ushicow/A2PDP11/kicad/a2pdp11.kicad_pcb

## KiCad design kicad/a2pdp11.kicad_pcb (2024-11-17)

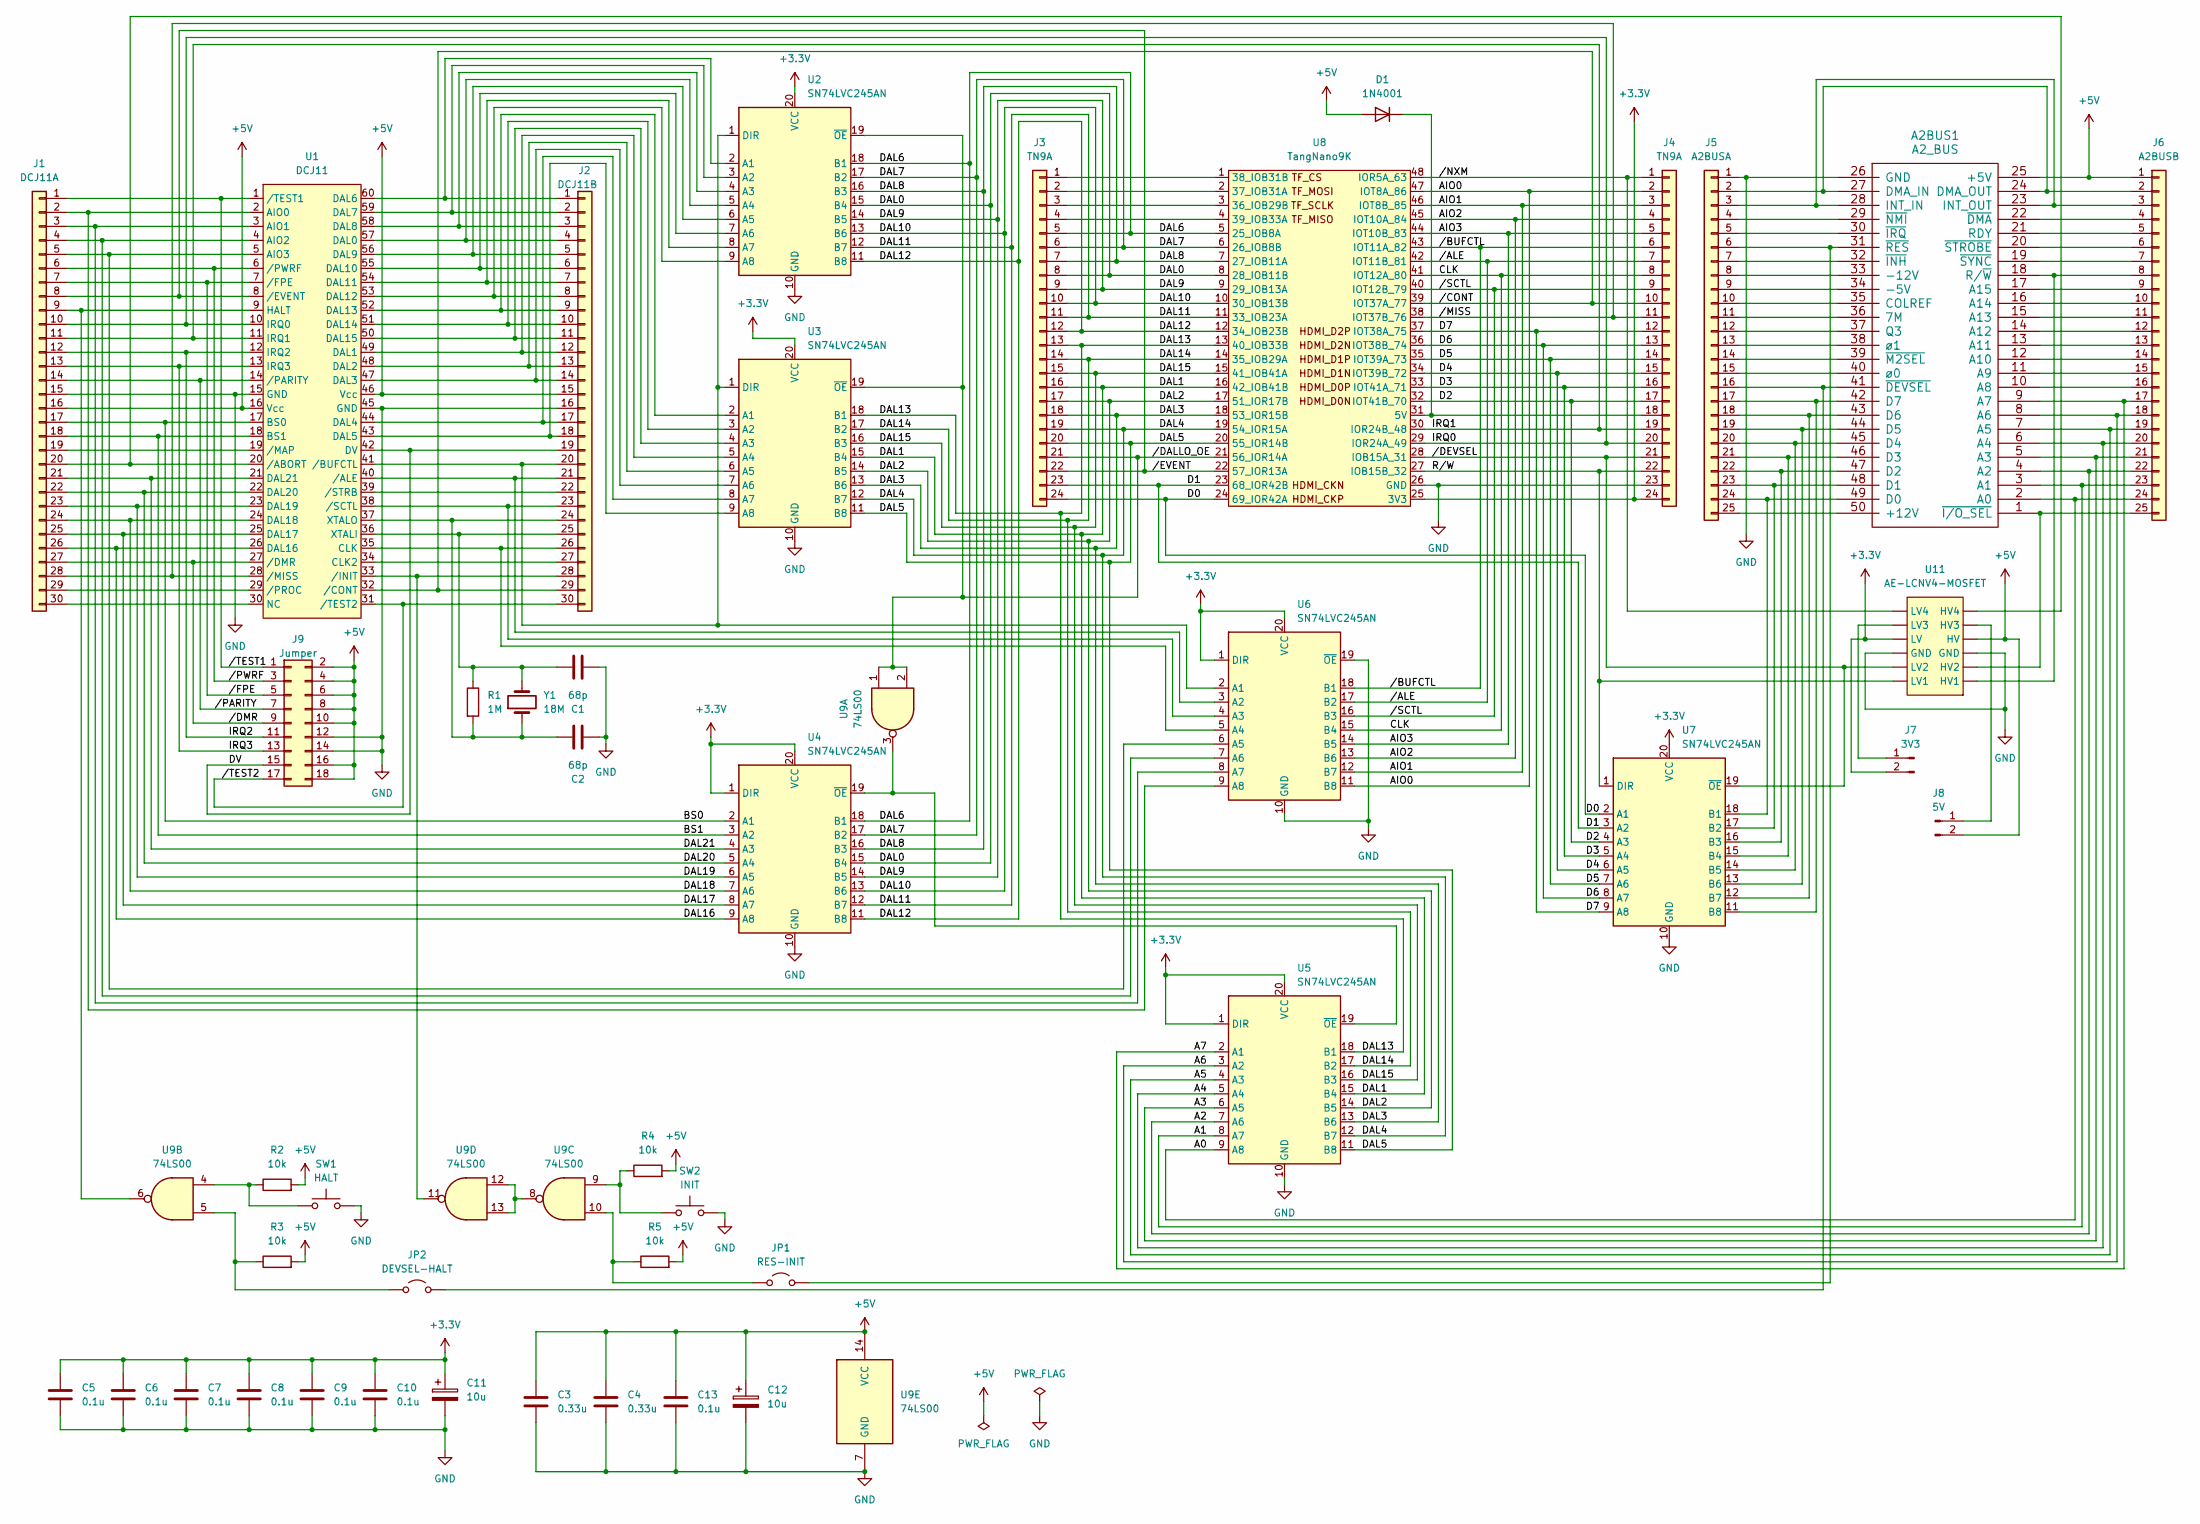
[picture p1: schematic a2pdp11.kicad_sch, J11 Test 17]

Parts:
A2BUS1: A2_BUS; BUS_A2
C1, C2: 68p; C_Disc_D3.0mm_W1.6mm_P2.54mm
C3, C4: 0.33u; C_Disc_D4.3mm_W1.9mm_P5.08mm
C5, C6, C7, C8, C9, C10, C13: 0.1u; C_Disc_D4.3mm_W1.9mm_P5.08mm
C11, C12: 10u; CP_Radial_D5.0mm_P2.00mm
D1: 1N4001; D_DO-41_SOD81_P10.16mm_Horizontal
J1: DCJ11A; PinHeader_1x30_P2.54mm_Vertical
J2: DCJ11B; PinHeader_1x30_P2.54mm_Vertical
J3, J4: TN9A; PinHeader_1x24_P2.54mm_Vertical
J5: A2BUSA; PinHeader_1x25_P2.54mm_Vertical
J6: A2BUSB; PinHeader_1x25_P2.54mm_Vertical
J7: 3V3; PinHeader_1x02_P2.54mm_Vertical
J8: 5V; PinHeader_1x02_P2.54mm_Vertical
J9: Jumper; PinHeader_2x09_P2.54mm_Vertical
JP1: RES-INIT; PinHeader_2x01_P2.54mm_Vertical
JP2: DEVSEL-HALT; PinHeader_2x01_P2.54mm_Vertical
R1: 1M; R_Axial_DIN0207_L6.3mm_D2.5mm_P10.16mm_Horizontal
R2, R3, R4, R5: 10k; R_Axial_DIN0207_L6.3mm_D2.5mm_P10.16mm_Horizontal
SW1: HALT; SW_PUSH_6mm_H4.3mm
SW2: INIT; SW_PUSH_6mm_H4.3mm
U1: DCJ11
U2, U3, U4, U5, U6, U7: SN74LVC245AN; DIP-20_W7.62mm
U8: TangNano9K
U9: 74LS00; DIP-14_W7.62mm_Socket
U11: AE-LCNV4-MOSFET
Y1: 18M; Crystal_HC18-U_Horizontal

Connections:
+3.3V: C5.1, C6.1, C7.1, C8.1, C9.1, C10.1, C11.1, J4.24, J7.2, U2.20 (VCC), U3.20 (VCC), U4.1 (DIR), U4.20 (VCC), U5.1 (DIR), U5.20 (VCC), U6.1 (DIR), U6.20 (VCC), U7.20 (VCC), U8.25 (3V3), U11.9 (LV)
+5V: A2BUS1.25 (+5V), C3.1, C4.1, C12.1, C13.1, D1.2 (A), J1.16, J2.15, J6.1, J8.2, J9.2, J9.4, J9.6, J9.8, J9.10, J9.16, J9.18, R2.2, R3.2, R4.2, R5.2, U1.16 (Vcc), U1.46 (Vcc), U9.14 (VCC), U11.4 (HV)
/A0: A2BUS1.2 (A0), J6.24, U5.9 (A8)
/A1: A2BUS1.3 (A1), J6.23, U5.8 (A7)
/A2: A2BUS1.4 (A2), J6.22, U5.7 (A6)
/A3: A2BUS1.5 (A3), J6.21, U5.6 (A5)
/A4: A2BUS1.6 (A4), J6.20, U5.5 (A4)
/A5: A2BUS1.7 (A5), J6.19, U5.4 (A3)
/A6: A2BUS1.8 (A6), J6.18, U5.3 (A2)
/A7: A2BUS1.9 (A7), J6.17, U5.2 (A1)
/AIO0: J4.2, U6.11 (B8), U8.47 (IOT8A_86)
/AIO1: J4.3, U6.12 (B7), U8.46 (IOT8B_85)
/AIO2: J4.4, U6.13 (B6), U8.45 (IOT10A_84)
/AIO3: J4.5, U6.14 (B5), U8.44 (IOT10B_83)
/BS0: J1.17, U1.17 (BS0), U4.2 (A1)
/BS1: J1.18, U1.18 (BS1), U4.3 (A2)
/CLK: J4.8, U6.15 (B4), U8.41 (IOT12A_80)
/D0: J3.24, U7.2 (A1), U8.24 (69_IOR42A)
/D1: J3.23, U7.3 (A2), U8.23 (68_IOR42B)
/D2: J4.17, U7.4 (A3), U8.32 (IOT41B_70)
/D3: J4.16, U7.5 (A4), U8.33 (IOT41A_71)
/D4: J4.15, U7.6 (A5), U8.34 (IOT39B_72)
/D5: J4.14, U7.7 (A6), U8.35 (IOT39A_73)
/D6: J4.13, U7.8 (A7), U8.36 (IOT38B_74)
/D7: J4.12, U7.9 (A8), U8.37 (IOT38A_75)
/DAL0: J3.8, U2.15 (B4), U4.15 (B4), U8.8 (28_IOB11B)
/DAL1: J3.16, U3.15 (B4), U5.15 (B4), U8.16 (42_IOB41B)
/DAL2: J3.17, U3.14 (B5), U5.14 (B5), U8.17 (51_IOR17B)
/DAL3: J3.18, U3.13 (B6), U5.13 (B6), U8.18 (53_IOR15B)
/DAL4: J3.19, U3.12 (B7), U5.12 (B7), U8.19 (54_IOR15A)
/DAL5: J3.20, U3.11 (B8), U5.11 (B8), U8.20 (55_IOR14B)
/DAL6: J3.5, U2.18 (B1), U4.18 (B1), U8.5 (25_IOB8A)
/DAL7: J3.6, U2.17 (B2), U4.17 (B2), U8.6 (26_IOB8B)
/DAL8: J3.7, U2.16 (B3), U4.16 (B3), U8.7 (27_IOB11A)
/DAL9: J3.9, U2.14 (B5), U4.14 (B5), U8.9 (29_IOB13A)
/DAL10: J3.10, U2.13 (B6), U4.13 (B6), U8.10 (30_IOB13B)
/DAL11: J3.11, U2.12 (B7), U4.12 (B7), U8.11 (33_IOB23A)
/DAL12: J3.12, U2.11 (B8), U4.11 (B8), U8.12 (34_IOB23B)
/DAL13: J3.13, U3.18 (B1), U5.18 (B1), U8.13 (40_IOB33B)
/DAL14: J3.14, U3.17 (B2), U5.17 (B2), U8.14 (35_IOB29A)
/DAL15: J3.15, U3.16 (B3), U5.16 (B3), U8.15 (41_IOB41A)
/DAL16: J1.26, U1.26 (DAL16), U4.9 (A8)
/DAL17: J1.25, U1.25 (DAL17), U4.8 (A7)
/DAL18: J1.24, U1.24 (DAL18), U4.7 (A6)
/DAL19: J1.23, U1.23 (DAL19), U4.6 (A5)
/DAL20: J1.22, U1.22 (DAL20), U4.5 (A4)
/DAL21: J1.21, U1.21 (DAL21), U4.4 (A3)
/DV: J2.19, J9.15, U1.42 (DV)
/IRQ0: J1.10, J4.20, U1.10 (IRQ0), U8.29 (IOR24A_49)
/IRQ1: J1.11, J4.19, U1.11 (IRQ1), U8.30 (IOR24B_48)
/IRQ2: J1.12, J9.11, U1.12 (IRQ2)
/IRQ3: J1.13, J9.13, U1.13 (IRQ3)
/R/W: J4.22, U7.1 (DIR), U8.27 (IOB15B_32), U11.12 (LV1)
//ALE: J4.7, U6.17 (B2), U8.42 (IOT11B_81)
//BUFCTL: J4.6, U6.18 (B1), U8.43 (IOT11A_82)
//CONT: J2.29, J4.10, U1.32 (/CONT), U8.39 (IOT37A_77)
//DALLO_OE: J3.21, U2.19 (~OE), U3.19 (~OE), U8.21 (56_IOR14A), U9.1, U9.2
//DEVSEL: J4.21, U7.19 (~OE), U8.28 (IOB15A_31), U11.11 (LV2)
//DMR: J1.27, J9.9, U1.27 (/DMR)
//EVENT: J1.8, J3.22, U1.8 (/EVENT), U8.22 (57_IOR13A)
//FPE: J1.7, J9.5, U1.7 (/FPE)
//MISS: J1.28, J4.11, U1.28 (/MISS), U8.38 (IOT37B_76)
//NXM: J4.1, U8.48 (IOR5A_63), U11.7 (LV4)
//PARITY: J1.14, J9.7, U1.14 (/PARITY)
//PWRF: J1.6, J9.3, U1.6 (/PWRF)
//SCTL: J4.9, U6.16 (B3), U8.40 (IOT12B_79)
//TEST1: J1.1, J9.1, U1.1 (/TEST1)
//TEST2: J2.30, J9.17, U1.31 (/TEST2)
GND: A2BUS1.26 (GND), C1.2, C2.2, C3.2, C4.2, C5.2, C6.2, C7.2, C8.2, C9.2, C10.2, C11.2, C12.2, C13.2, J1.15, J2.16, J4.23, J5.1, J9.12, J9.14, SW1.2, SW2.2, U1.15 (GND), U1.45 (GND), U2.10 (GND), U3.10 (GND), U4.10 (GND), U5.10 (GND), U6.10 (GND), U6.19 (~OE), U7.10 (GND), U8.26 (GND), U9.7 (GND), U11.3 (GND), U11.10 (GND)
unnamed: A2BUS1.36 (7M), J5.11
unnamed: A2BUS1.50 (+12V), J5.25
unnamed: A2BUS1.34 (-5V), J5.9
unnamed: A2BUS1.33 (-12V), J5.8
unnamed: A2BUS1.10 (A8), J6.16
unnamed: A2BUS1.11 (A9), J6.15
unnamed: A2BUS1.12 (A10), J6.14
unnamed: A2BUS1.13 (A11), J6.13
unnamed: A2BUS1.14 (A12), J6.12
unnamed: A2BUS1.15 (A13), J6.11
unnamed: A2BUS1.16 (A14), J6.10
unnamed: A2BUS1.17 (A15), J6.9
unnamed: A2BUS1.35 (COLREF), J5.10
unnamed: A2BUS1.49 (D0), J5.24, U7.18 (B1)
unnamed: A2BUS1.48 (D1), J5.23, U7.17 (B2)
unnamed: A2BUS1.47 (D2), J5.22, U7.16 (B3)
unnamed: A2BUS1.46 (D3), J5.21, U7.15 (B4)
unnamed: A2BUS1.45 (D4), J5.20, U7.14 (B5)
unnamed: A2BUS1.44 (D5), J5.19, U7.13 (B6)
unnamed: A2BUS1.43 (D6), J5.18, U7.12 (B7)
unnamed: A2BUS1.42 (D7), J5.17, U7.11 (B8)
unnamed: A2BUS1.24 (DMA_OUT), A2BUS1.27 (DMA_IN), J5.2, J6.2
unnamed: A2BUS1.23 (INT_OUT), A2BUS1.28 (INT_IN), J5.3, J6.3
unnamed: A2BUS1.37 (Q3), J5.12
unnamed: A2BUS1.21 (RDY), J6.5
unnamed: A2BUS1.18 (R/~W), J6.8, U11.1 (HV1)
unnamed: A2BUS1.41 (~DEVSEL), J5.16, JP2.2 (B)
unnamed: A2BUS1.22 (~DMA), J6.4
unnamed: A2BUS1.32 (~INH), J5.7
unnamed: A2BUS1.30 (~IRQ), J5.5
unnamed: A2BUS1.1 (~I/O_SEL), J6.25, U11.2 (HV2)
unnamed: A2BUS1.39 (~M2SEL), J5.14
unnamed: A2BUS1.29 (~NMI), J5.4
unnamed: A2BUS1.31 (~RES), J5.6, JP1.2 (B)
unnamed: A2BUS1.20 (~STROBE), J6.6
unnamed: A2BUS1.19 (~SYNC), J6.7
unnamed: A2BUS1.40 (ø0), J5.15
unnamed: A2BUS1.38 (ø1), J5.13
unnamed: D1.1 (K), J4.18, U8.31 (5V)
unnamed: J1.2, U1.2 (AIO0), U6.9 (A8)
unnamed: J1.3, U1.3 (AIO1), U6.8 (A7)
unnamed: J1.4, U1.4 (AIO2), U6.7 (A6)
unnamed: J1.5, U1.5 (AIO3), U6.6 (A5)
unnamed: J1.9, U1.9 (HALT), U9.6
unnamed: J1.19, U1.19 (/MAP)
unnamed: J1.20, U1.20 (/ABORT), U11.6 (HV4)
unnamed: J1.29, U1.29 (/PROC)
unnamed: J1.30, U1.30 (NC)
unnamed: J2.1, U1.60 (DAL6), U2.2 (A1)
unnamed: J2.2, U1.59 (DAL7), U2.3 (A2)
unnamed: J2.3, U1.58 (DAL8), U2.4 (A3)
unnamed: J2.4, U1.57 (DAL0), U2.5 (A4)
unnamed: J2.5, U1.56 (DAL9), U2.6 (A5)
unnamed: J2.6, U1.55 (DAL10), U2.7 (A6)
unnamed: J2.7, U1.54 (DAL11), U2.8 (A7)
unnamed: J2.8, U1.53 (DAL12), U2.9 (A8)
unnamed: J2.9, U1.52 (DAL13), U3.2 (A1)
unnamed: J2.10, U1.51 (DAL14), U3.3 (A2)
unnamed: J2.11, U1.50 (DAL15), U3.4 (A3)
unnamed: J2.12, U1.49 (DAL1), U3.5 (A4)
unnamed: J2.13, U1.48 (DAL2), U3.6 (A5)
unnamed: J2.14, U1.47 (DAL3), U3.7 (A6)
unnamed: J2.17, U1.44 (DAL4), U3.8 (A7)
unnamed: J2.18, U1.43 (DAL5), U3.9 (A8)
unnamed: J2.20, U1.41 (/BUFCTL), U2.1 (DIR), U3.1 (DIR), U6.2 (A1)
unnamed: J2.21, U1.40 (/ALE), U6.3 (A2)
unnamed: J2.22, U1.39 (/STRB)
unnamed: J2.23, U1.38 (/SCTL), U6.4 (A3)
unnamed: C2.1, J2.24, R1.2, U1.37 (XTALO), Y1.1
unnamed: C1.1, J2.25, R1.1, U1.36 (XTALI), Y1.2
unnamed: J2.26, U1.35 (CLK), U6.5 (A4)
unnamed: J2.27, U1.34 (CLK2)
unnamed: J2.28, U1.33 (/INIT), U9.11
unnamed: J3.1, U8.1 (38_IOB31B)
unnamed: J3.2, U8.2 (37_IOB31A)
unnamed: J3.3, U8.3 (36_IOB29B)
unnamed: J3.4, U8.4 (39_IOB33A)
unnamed: J7.1, U11.8 (LV3)
unnamed: J8.1, U11.5 (HV3)
unnamed: JP1.1 (A), R5.1, U9.10
unnamed: JP2.1 (A), R3.1, U9.5
unnamed: R2.1, SW1.1, U9.4
unnamed: R4.1, SW2.1, U9.9
unnamed: U4.19 (~OE), U5.19 (~OE), U9.3
unnamed: U9.8, U9.12, U9.13

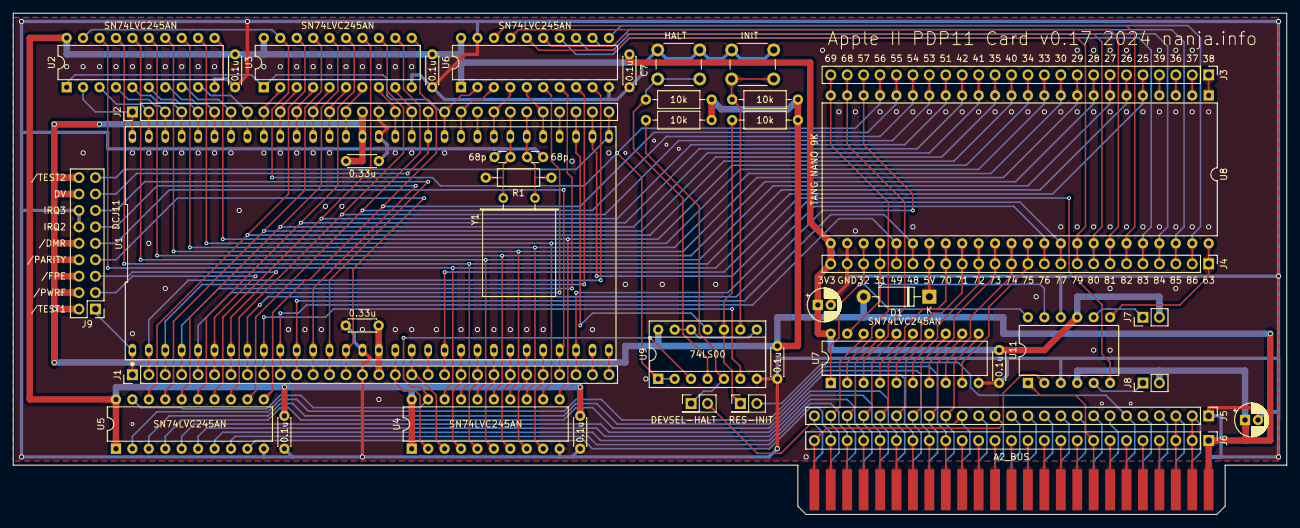
[picture p2: board a2pdp11.kicad_pcb from above]

Board: 2 copper layers, 196.9 x 77.5 mm, 44 parts (0 on the bottom side), 154 nets.
