ushicow/A2PDP11/src/gowin_rpll/gowin_rpll_ram_tmp.v

//Copyright (C)2014-2024 Gowin Semiconductor Corporation.
//All rights reserved.
//File Title: Template file for instantiation
//Tool Version: V1.9.10.03 (64-bit)
//Part Number: GW1NR-LV9QN88PC6/I5
//Device: GW1NR-9
//Device Version: C
//Created Time: Sun Nov 24 13:46:31 2024

//Change the instance name and port connections to the signal names
//--------Copy here to design--------

    Gowin_rPLL_ram your_instance_name(
        .clkout(clkout), //output clkout
        .lock(lock), //output lock
        .clkoutp(clkoutp), //output clkoutp
        .clkoutd(clkoutd), //output clkoutd
        .clkoutd3(clkoutd3), //output clkoutd3
        .clkin(clkin) //input clkin
    );

//--------Copy end-------------------
