ushicow/A2PDP11/(commit log)

2024-10-22 add kicad schematic
    [a2pdp11.kicad_pcb, a2pdp11.kicad_sch]
2024-10-22 add arduino
2024-10-22 chenge arduino directory
2024-10-23 aio multiplexed
    [a2pdp11.kicad_sch]
2024-10-25 dalhi_oe_n = !dalhi_oe_n
    [a2pdp11.kicad_sch]
2024-11-02 run BASIC, but unstable
    [a2pdp11.kicad_sch]
2024-11-10 Apple II interface
    [a2pdp11.kicad_pcb, a2pdp11.kicad_sch, bom.csv, designators.csv, positions.csv]
2024-11-17 Change I/O signal to IOSEL
    [a2pdp11.kicad_pcb, a2pdp11.kicad_sch]
2024-12-01 PC11 paper tape reader
    [a2pdp11.kicad_sch]
